intelligent-soft-robots/ball_launcher_hardware/README.md

# Ball Launcher Hardware

This repo provides materials for duplication and distribution of our open-source table tennis ball launcher AIMY.

Given are:
- Datasheets
- Technical sketches of all assemblies
- CAD models given as SolidWorks-files and STEP-files
