intelligent-soft-robots/ball_launcher_hardware/(list of files, cad)

Other CAD files:
3d_models/ball_feeding_unit.STEP
3d_models/control_unit_with_housing.STEP
3d_models/ball_feeding_unit_intake.STEP
3d_models/launch_unit.STEP
3d_models/base_frame_with_supply_channel.STEP
3d_models/reservoir_stirrer.STEP
3d_models/launch_unit_shooting_wheel.STEP
3d_models/electronics_box.STEP
3d_models/launch_unit_steering_tube.STEP
3d_models/cable_duct.STEP
3d_models/launch_unit_bearing.STEP
3d_models/aimy.STEP
3d_models/aimy_without_screws.STEP
