intelligent-soft-robots/ball_launcher_hardware/technical_drawings/assembly_ball_feeding_unit_3D.PDF

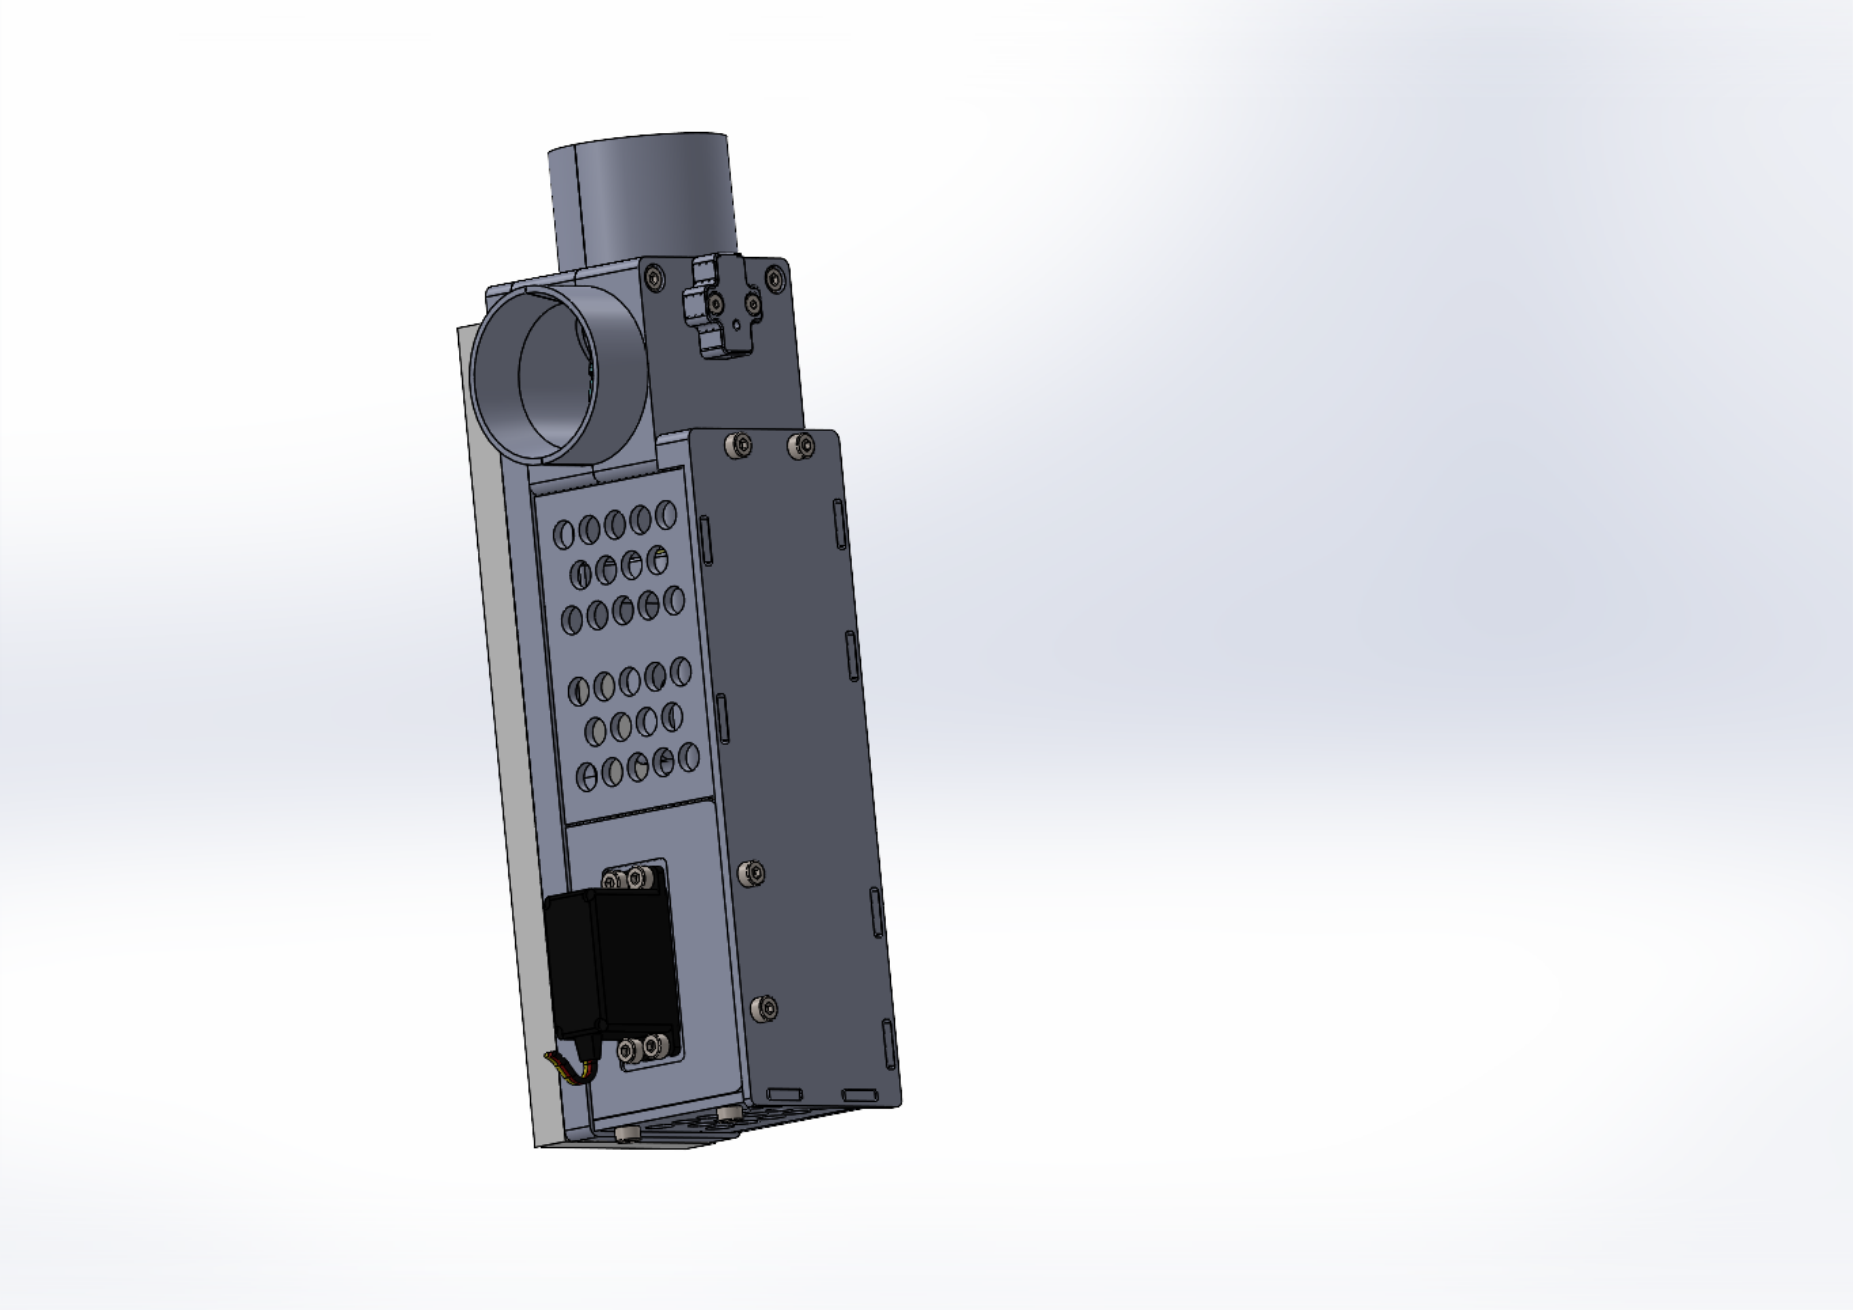
[picture p13: page 1]
