intelligent-soft-robots/ball_launcher_hardware/technical_drawings/assembly_cable_duct_3D.PDF

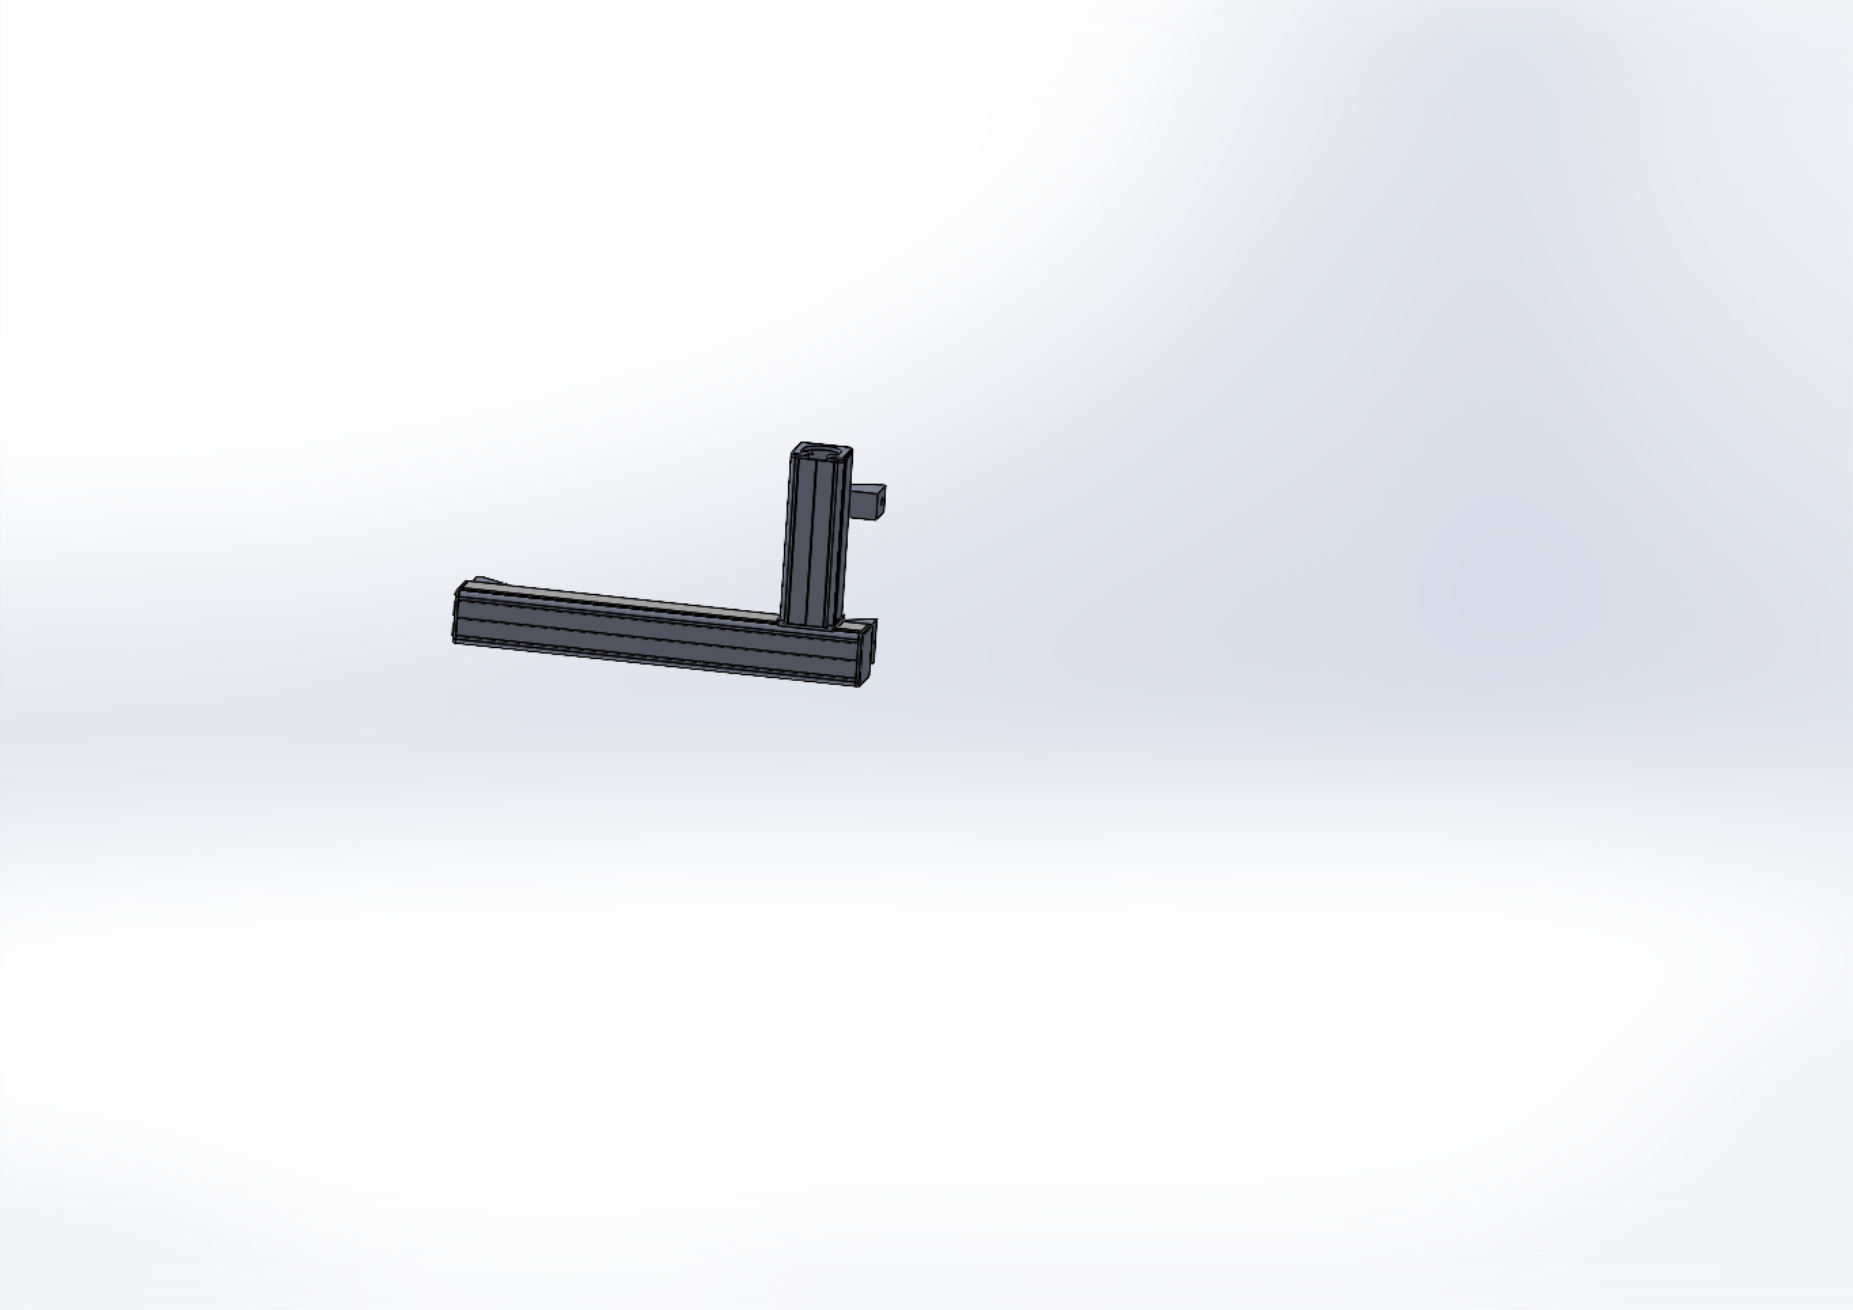
[picture p14: page 1]
