intelligent-soft-robots/ball_launcher_hardware/technical_drawings/assembly_aimy.pdf

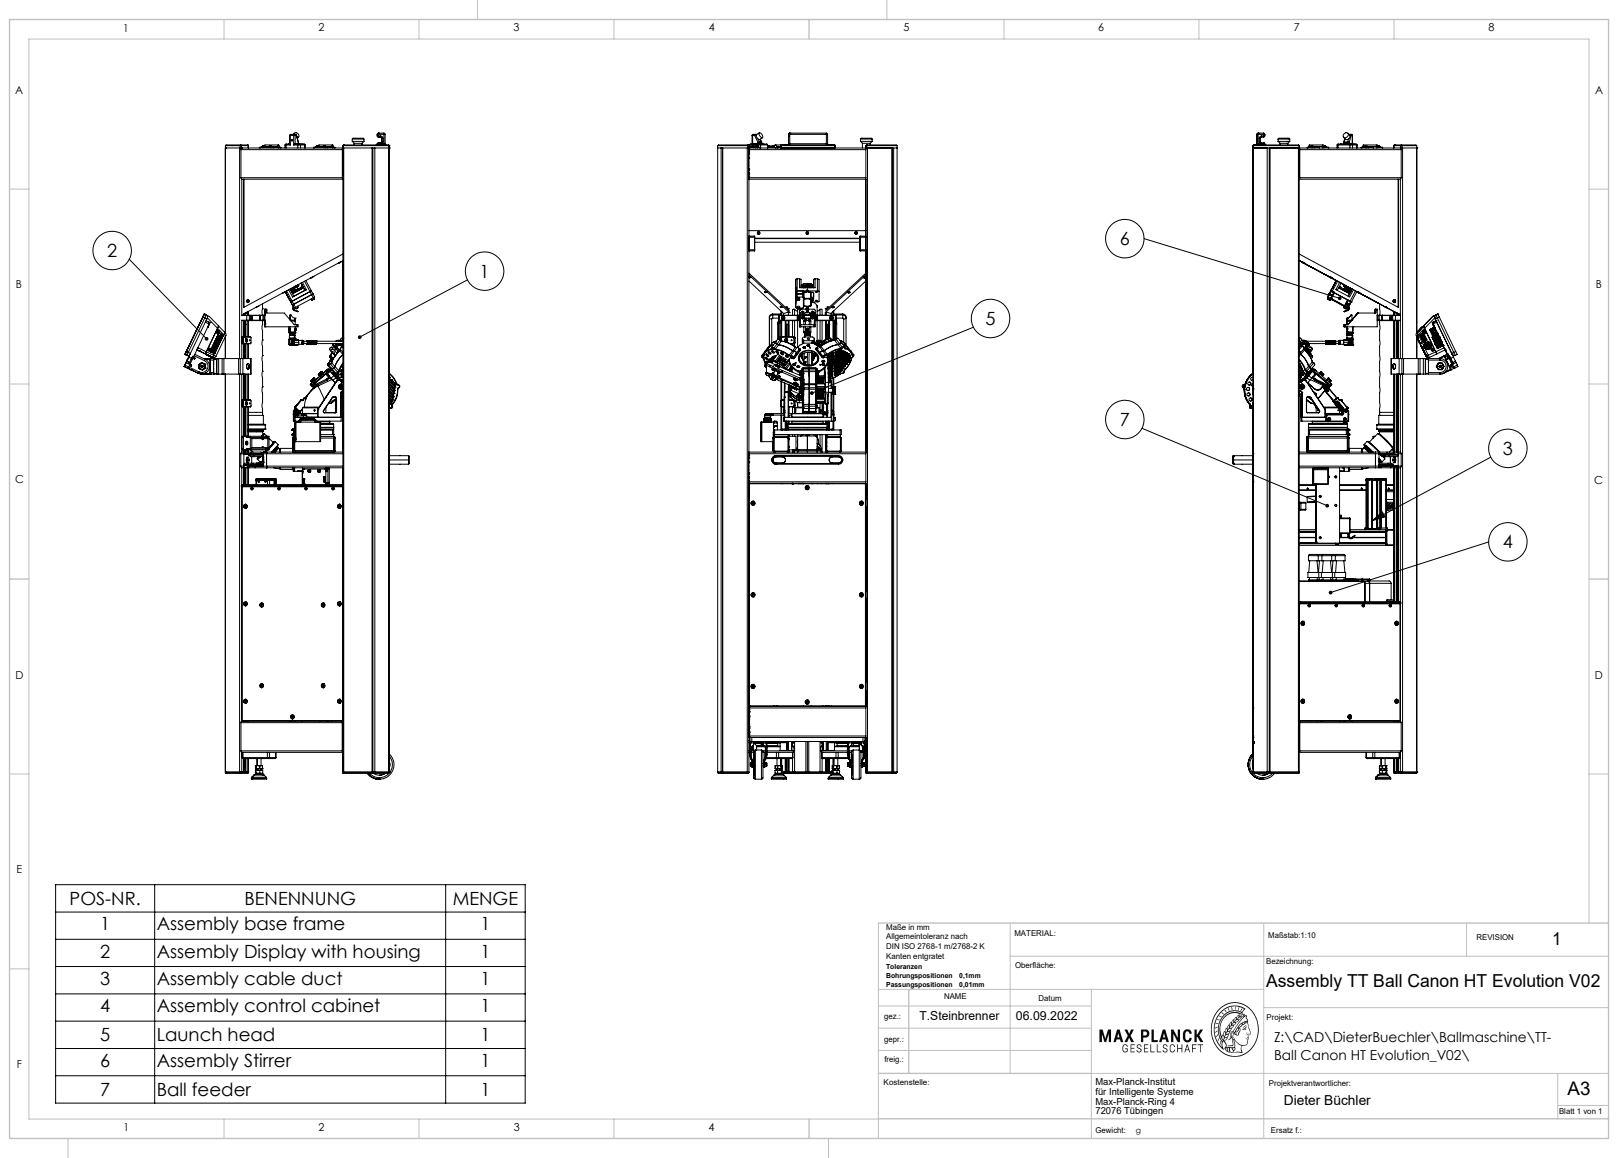
[picture p1: page 1]
Assembly Stirrer; Ball feeder; Ersatz f.:; Blatt 1 von 1; Dieter Büchler

POS-NR. | BENENNUNG | MENGE
1 | Assembly base frame | 1
2 | Assembly Display with housing | 1
3 | Assembly cable duct | 1
4 | Assembly control cabinet | 1
5 | Launch head | 1

Maße in mm Allgemeintoleranz nach DIN ISO 2768-1 m/2768-2 K Kanten entgratet Toleranzen Bohrungspositionen 0,1mm Passungspositionen 0,01mm | | Maßstab:1:10 | 1 REVISION MATERIAL:

Oberfläche: | Bezeichnung: Assembly TT Ball Canon HT Evolution V02

NAME | Datum

gez.: | T.Steinbrenner | 06.09.2022 | | Projekt: Z:\CAD\DieterBuechler\Ballmaschine\TT-Ball Canon HT Evolution_V02\

gepr.:

Max-Planck-Institut
für Intelligente Systeme
Max-Planck-Ring 4
72076 Tübingen
Gewicht:
