intelligent-soft-robots/ball_launcher_hardware/technical_drawings/assembly_ball_feeding_unit_intake.pdf

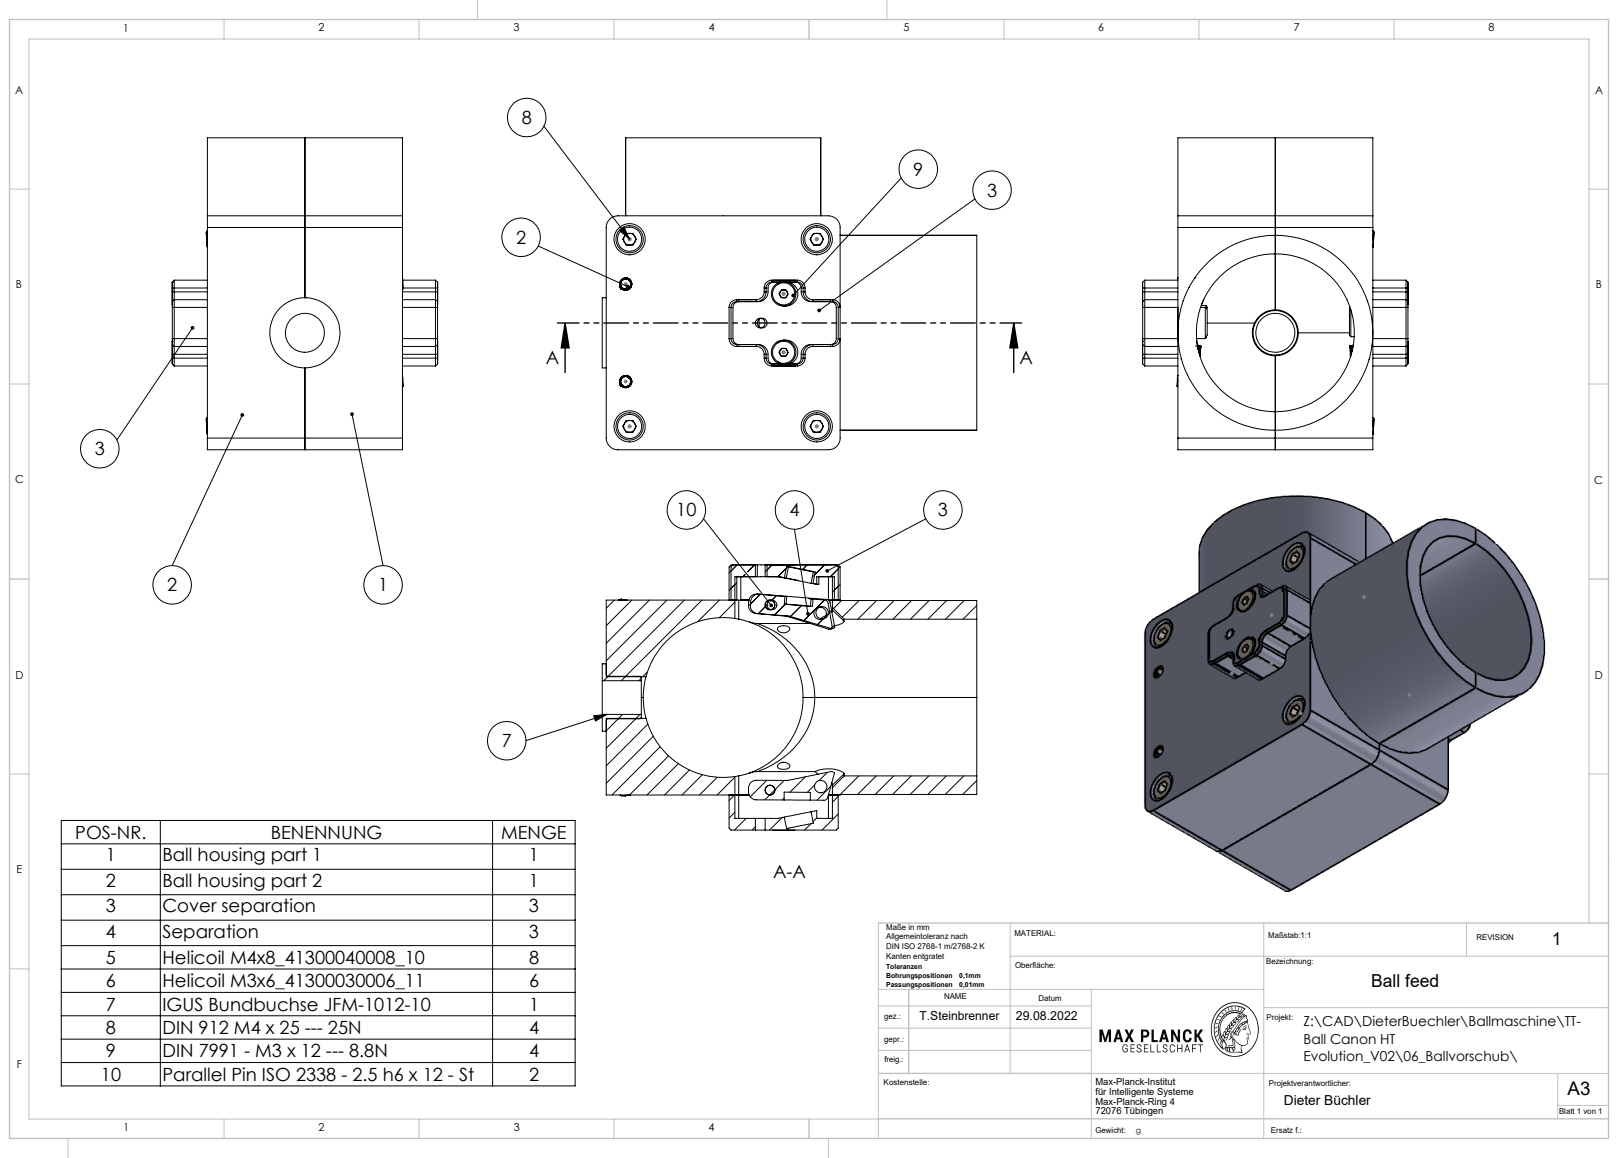
[picture p3: page 1]
IGUS Bundbuchse JFM-1012-10; Ersatz f.:; Blatt 1 von 1; REVISION MATERIAL:

POS-NR. | BENENNUNG | MENGE
1 | Ball housing part 1 | 1
2 | Ball housing part 2 | 1
3 | Cover separation | 3

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

5 | Helicoil M4x8_41300040008_10 | 8
6 | Helicoil M3x6_41300030006_11 | 6
8 | DIN 912 M4 x 25 --- 25N | 4
9 | DIN 7991 - M3 x 12 --- 8.8N | 4
10 | Parallel Pin ISO 2338 - 2.5 h6 x 12 - St | 2

Oberfläche: | Bezeichnung: Ball feed

gez.: | T.Steinbrenner | 29.08.2022 | | Projekt: Z:\CAD\DieterBuechler\Ballmaschine\TT-Ball Canon HT Evolution_V02\06_Ballvorschub\

gepr.:
freig.:

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
