intelligent-soft-robots/ball_launcher_hardware/technical_drawings/assembly_base_frame_with_supply_channel.pdf

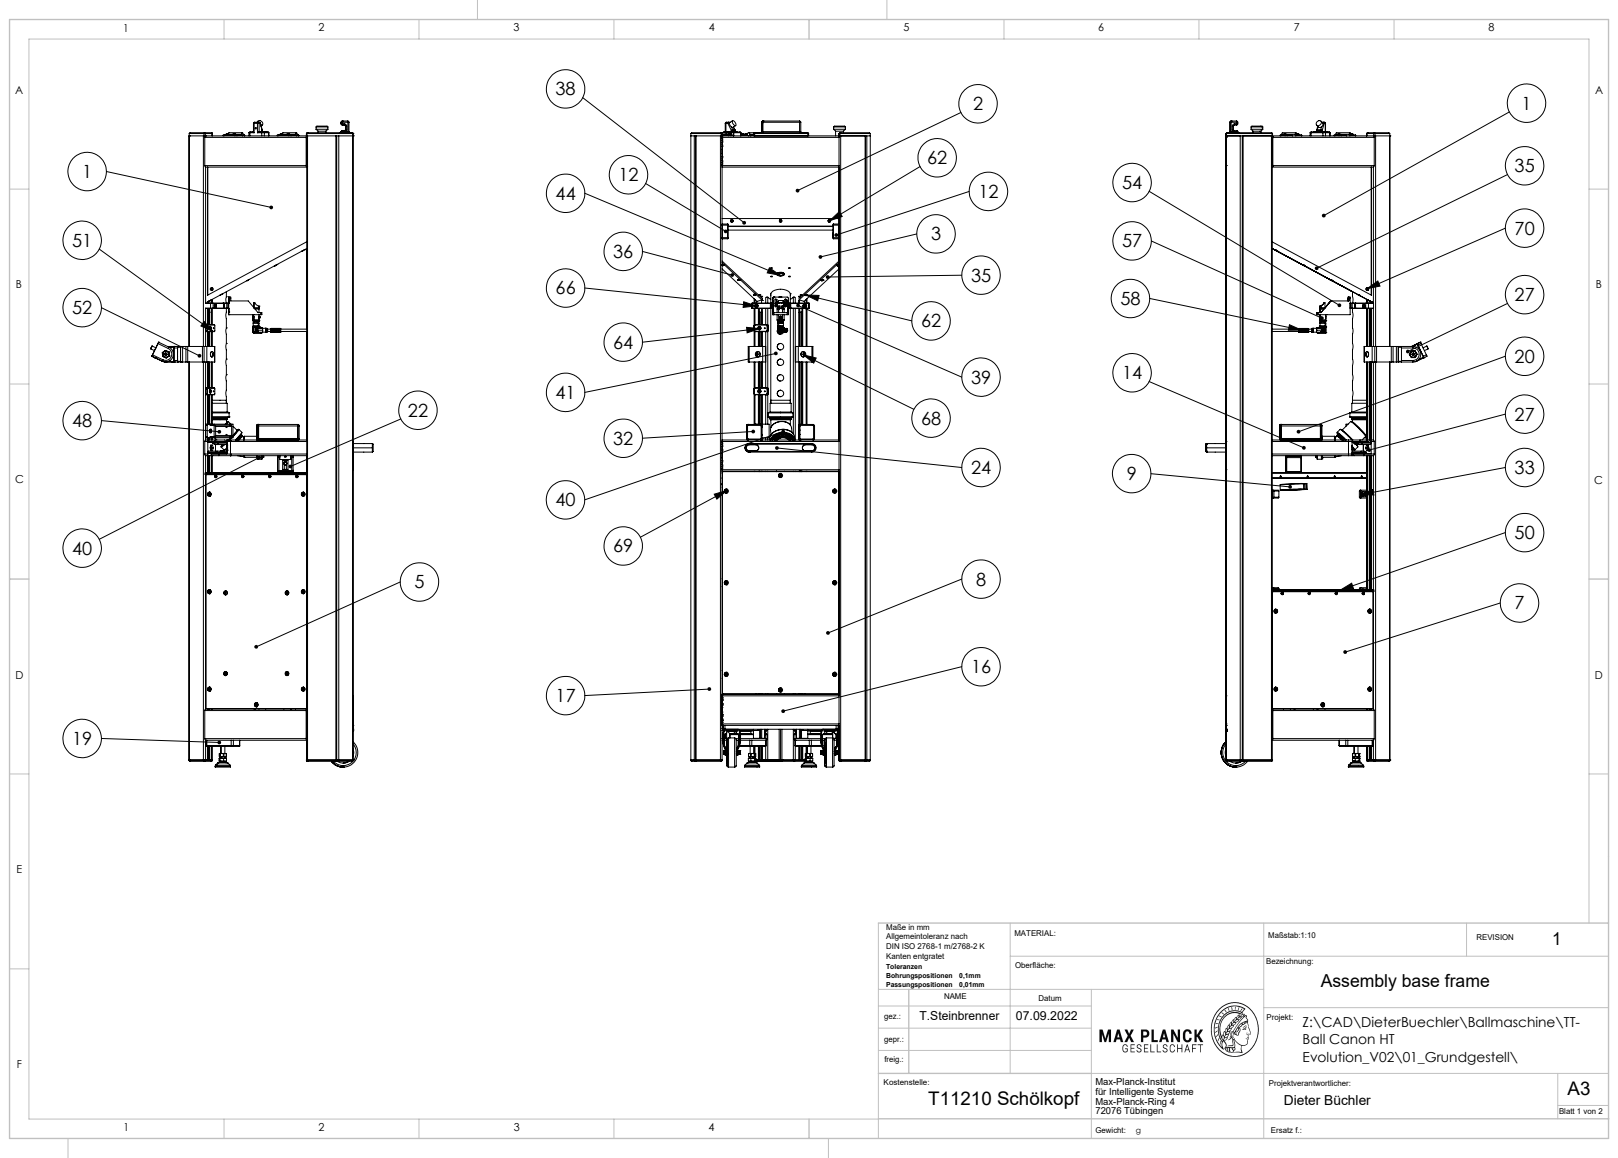
[picture p4: page 1]
Ersatz f.:; Blatt 1 von 2

Maße in mm Allgemeintoleranz nach DIN ISO 2768-1 m/2768-2 K Kanten entgratet Toleranzen Bohrungspositionen 0,1mm Passungspositionen 0,01mm | | Maßstab:1:10 | 1 REVISION MATERIAL:

Oberfläche: | Bezeichnung: Assembly base frame

NAME | Datum

gez.: | T.Steinbrenner | 07.09.2022 | | Projekt: Z:\CAD\DieterBuechler\Ballmaschine\TT-Ball Canon HT Evolution_V02\01_Grundgestell\

gepr.:
freig.:

Kostenstelle: T11210 Schölkopf | Max-Planck-Institut für Intelligente Systeme Max-Planck-Ring 4 72076 Tübingen | Projektverantwortlicher: Dieter Büchler | A3

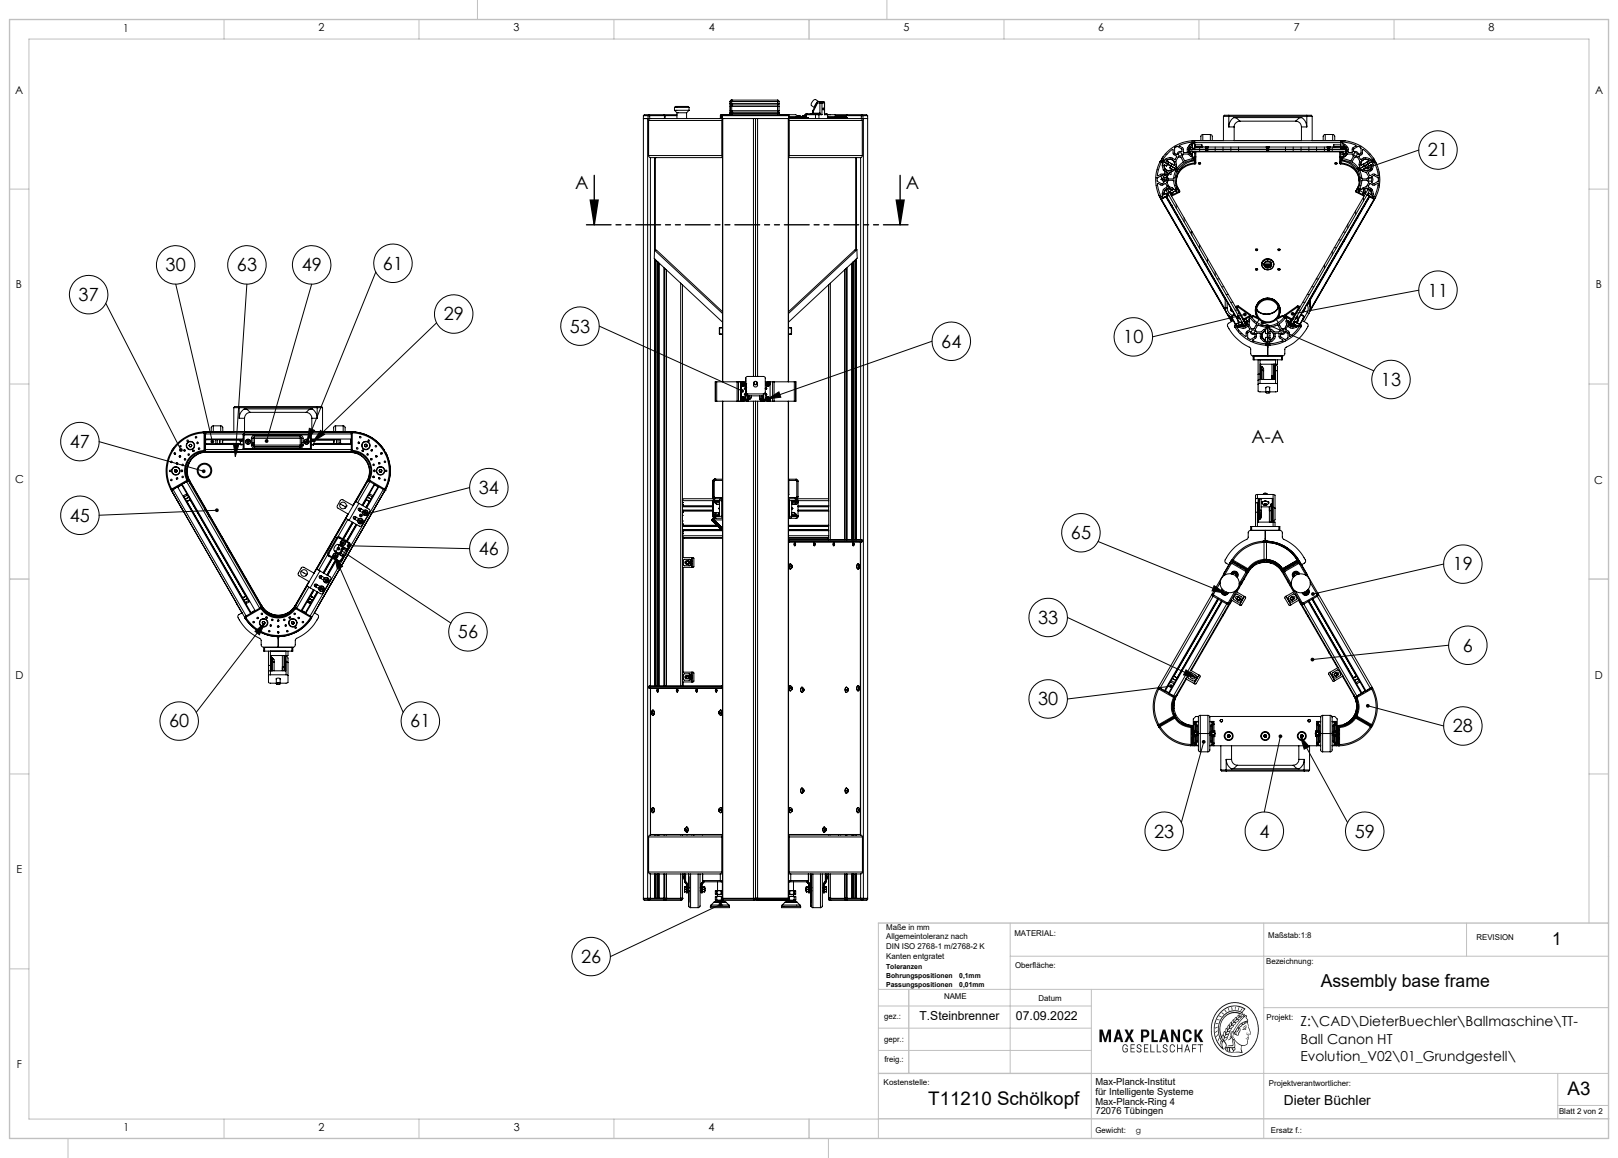
[picture p5: page 2]
Ersatz f.:; Blatt 2 von 2

Maße in mm Allgemeintoleranz nach DIN ISO 2768-1 m/2768-2 K Kanten entgratet Toleranzen Bohrungspositionen 0,1mm Passungspositionen 0,01mm | | Maßstab:1:8 | 1 REVISION MATERIAL:

Oberfläche: | Bezeichnung: Assembly base frame

NAME | Datum

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

gepr.:
freig.:

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
