intelligent-soft-robots/ball_launcher_hardware/technical_drawings/assembly_cable_duct.pdf

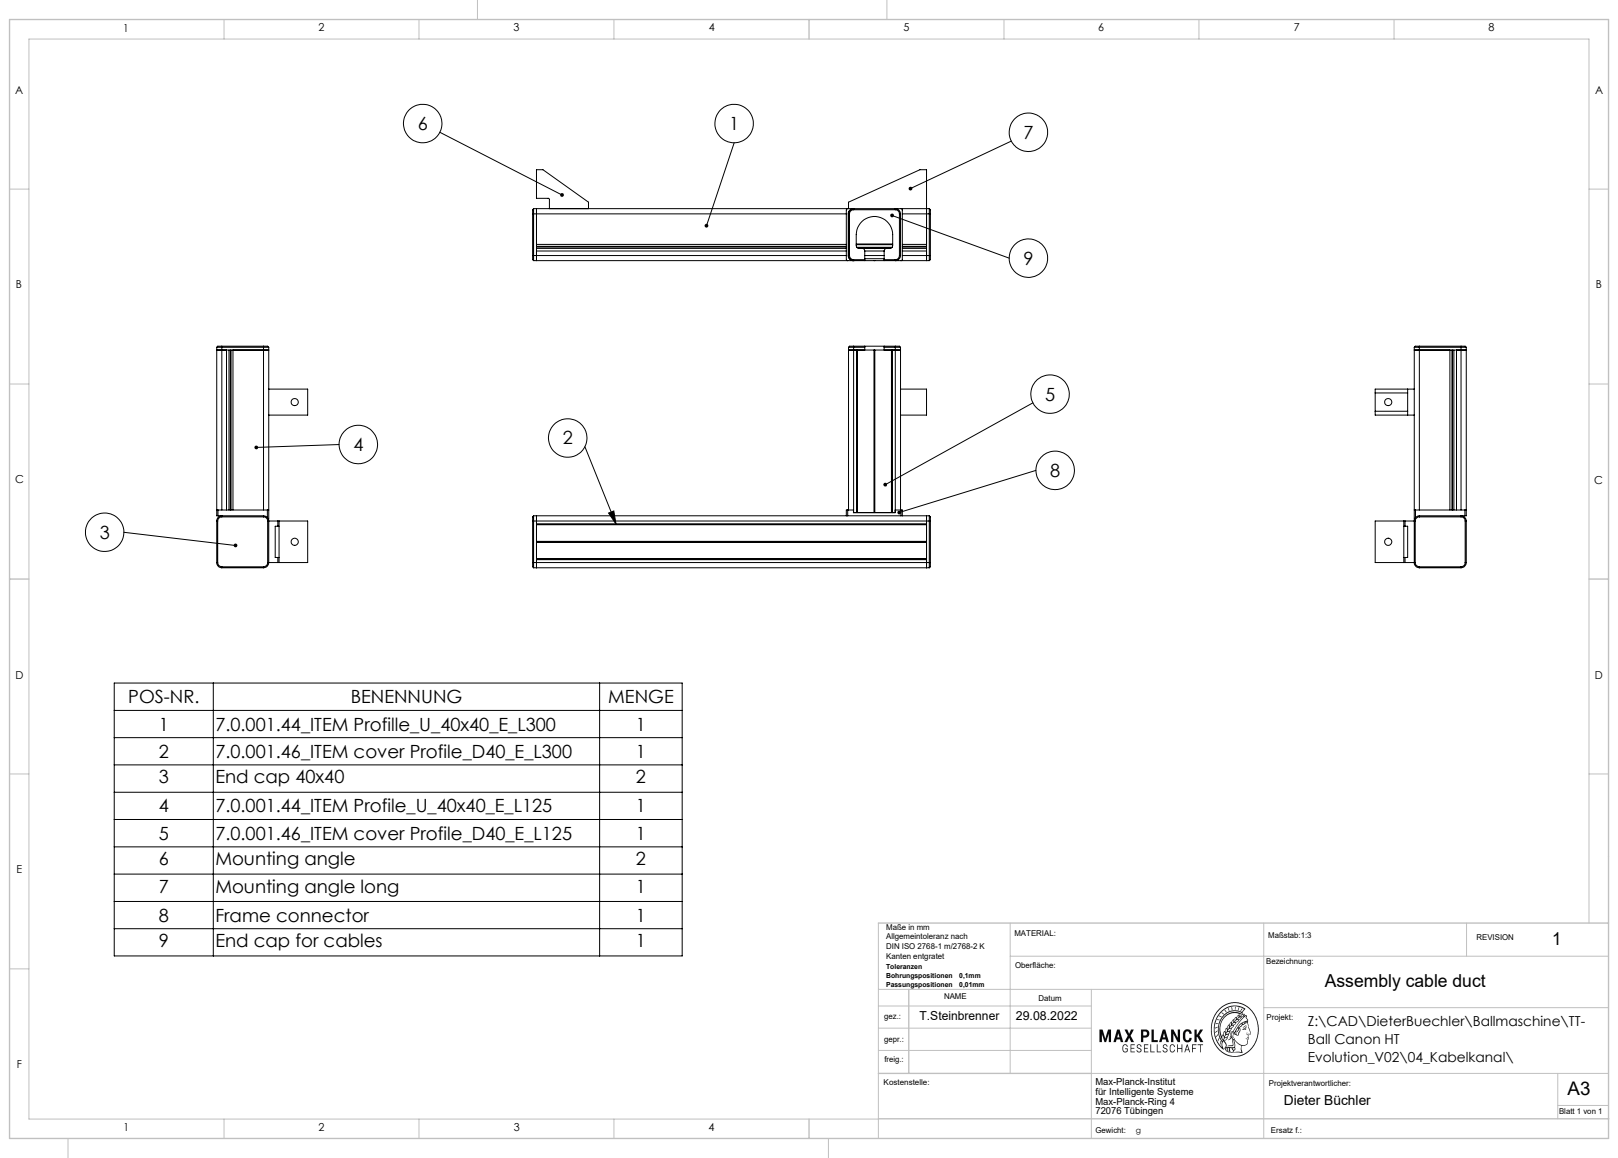
[picture p6: page 1]
Ersatz f.:; Blatt 1 von 1

POS-NR. | BENENNUNG | MENGE
1 | 7.0.001.44_ITEM Profille_U_40x40_E_L300 | 1
2 | 7.0.001.46_ITEM cover Profile_D40_E_L300 | 1
3 | End cap 40x40 | 2
4 | 7.0.001.44_ITEM Profile_U_40x40_E_L125 | 1
5 | 7.0.001.46_ITEM cover Profile_D40_E_L125 | 1
6 | Mounting angle | 2
7 | Mounting angle long | 1
8 | Frame connector | 1
9 | End cap for cables | 1

Maße in mm Allgemeintoleranz nach DIN ISO 2768-1 m/2768-2 K Kanten entgratet Toleranzen Bohrungspositionen 0,1mm Passungspositionen 0,01mm | | Maßstab:1:3 | 1 REVISION MATERIAL:

Oberfläche: | Bezeichnung: Assembly cable duct

NAME | Datum

gez.: | T.Steinbrenner | 29.08.2022 | | Projekt: Z:\CAD\DieterBuechler\Ballmaschine\TT-Ball Canon HT Evolution_V02\04_Kabelkanal\

gepr.:
freig.:

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
