intelligent-soft-robots/ball_launcher_hardware/technical_drawings/assembly_electronics_box.pdf

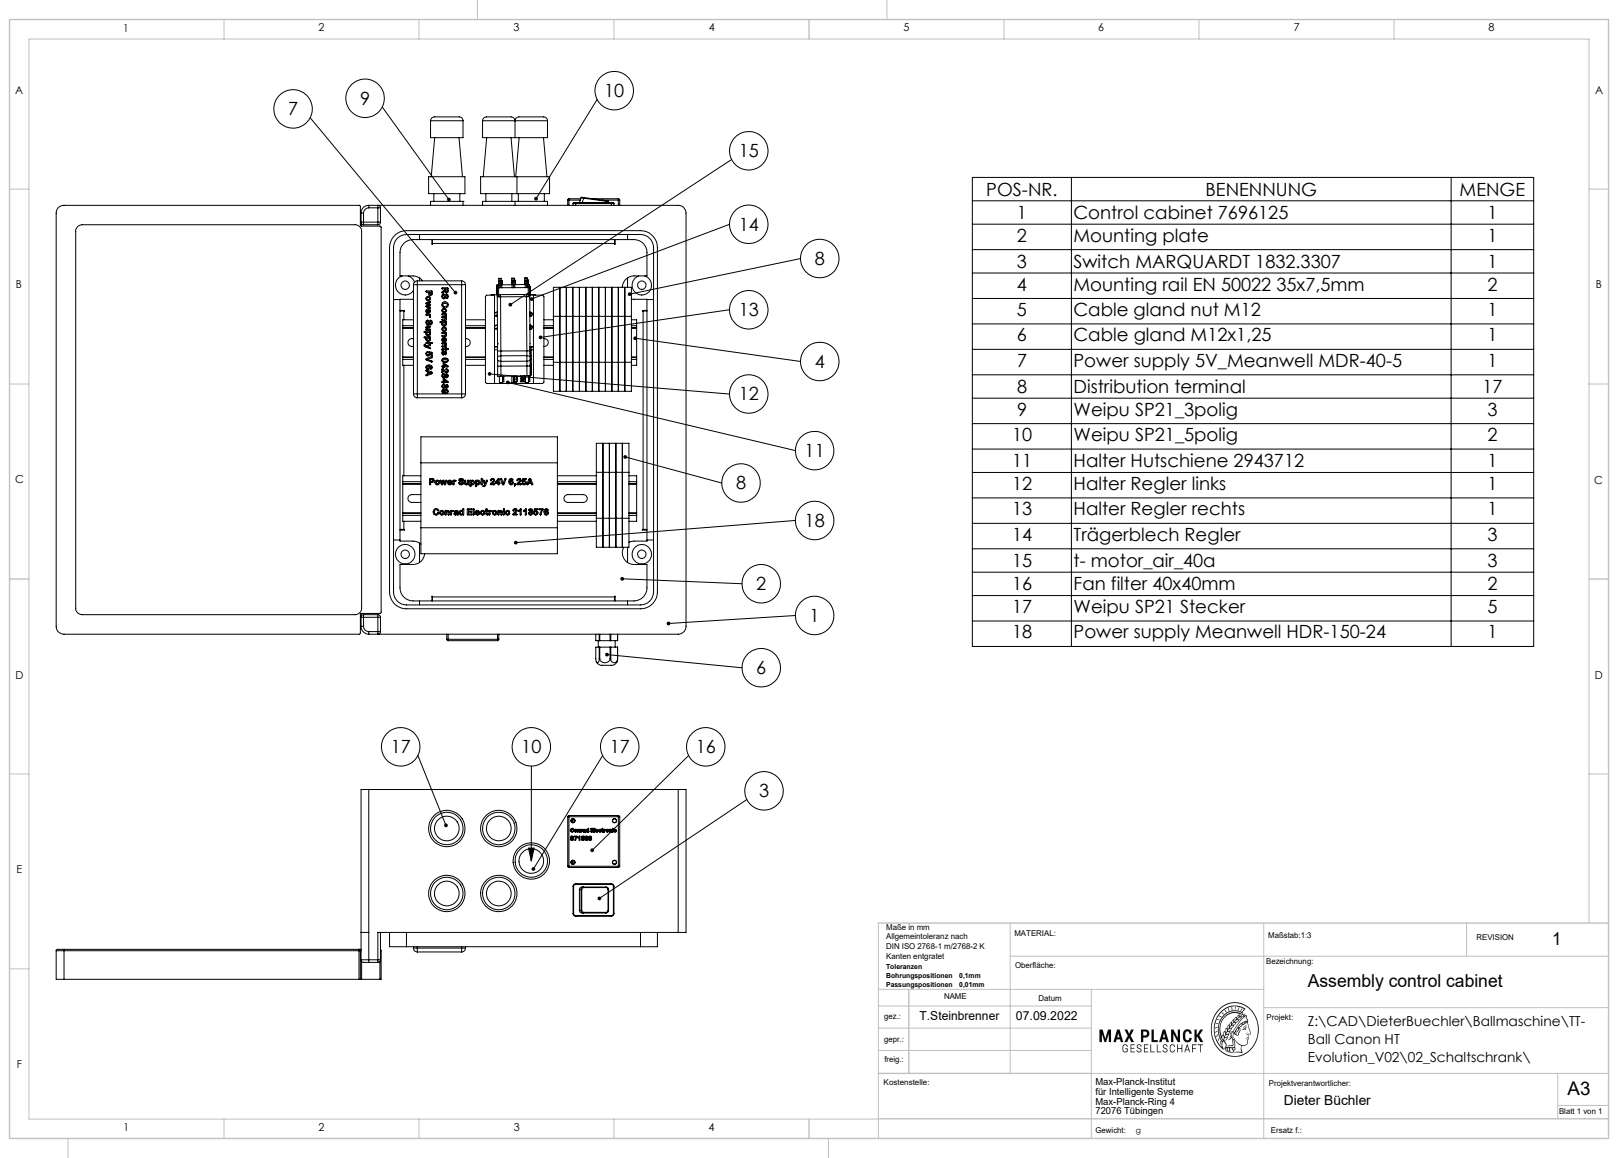
[picture p8: page 1]
POS-NR.; BENENNUNG; MENGE 1; Control cabinet 7696125; Mounting plate; Switch MARQUARDT 1832.3307; Mounting rail EN 50022 35x7,5mm; Cable gland nut M12; Cable gland M12x1,25; Power supply 5V_Meanwell MDR-40-5; Distribution terminal; Weipu SP21_3polig; Ersatz f.:; Blatt 1 von 1

10 | Weipu SP21_5polig | 2
11 | Halter Hutschiene 2943712 | 1
12 | Halter Regler links | 1
13 | Halter Regler rechts | 1
14 | Trägerblech Regler | 3
15 | t- motor_air_40a | 3
16 | Fan filter 40x40mm | 2
17 | Weipu SP21 Stecker | 5
18 | Power supply Meanwell HDR-150-24 | 1

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

Oberfläche: | Bezeichnung: Assembly control cabinet

NAME | Datum

gez.: | T.Steinbrenner | 07.09.2022 | | Projekt: Z:\CAD\DieterBuechler\Ballmaschine\TT-Ball Canon HT Evolution_V02\02_Schaltschrank\

gepr.:
freig.:

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
