intelligent-soft-robots/ball_launcher_hardware/technical_drawings/assembly_launch_unit_bearing.pdf

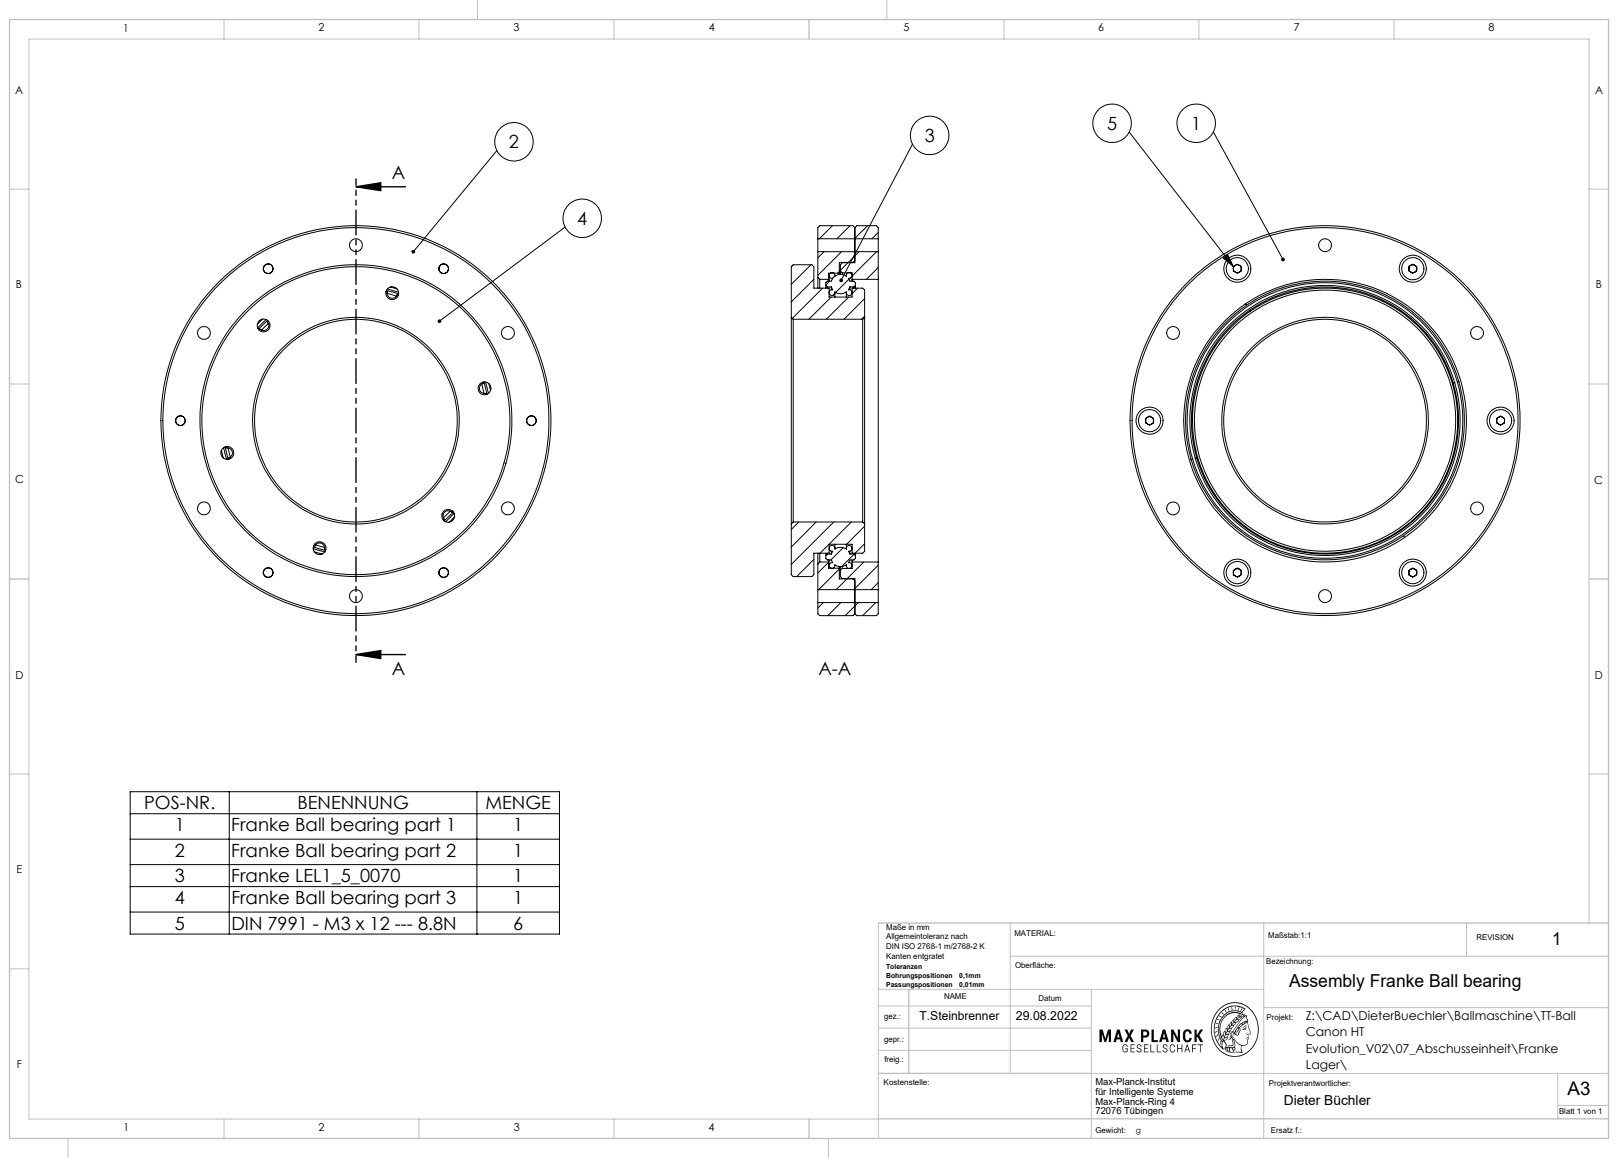
[picture p9: page 1]
Ersatz f.:; Blatt 1 von 1

POS-NR. | BENENNUNG | MENGE
1 | Franke Ball bearing part 1 | 1
2 | Franke Ball bearing part 2 | 1
3 | Franke LEL1_5_0070 | 1
4 | Franke Ball bearing part 3 | 1
5 | DIN 7991 - M3 x 12 --- 8.8N | 6

Maße in mm Allgemeintoleranz nach DIN ISO 2768-1 m/2768-2 K Kanten entgratet Toleranzen Bohrungspositionen 0,1mm Passungspositionen 0,01mm | | Maßstab:1:1 | 1 REVISION MATERIAL:

Oberfläche: | Bezeichnung: Assembly Franke Ball bearing

NAME | Datum

gez.: | T.Steinbrenner | 29.08.2022 | | Z:\CAD\DieterBuechler\Ballmaschine\TT-Ball Projekt: Canon HT Evolution_V02\07_Abschusseinheit\Franke Lager\

gepr.:
freig.:

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
