intelligent-soft-robots/ball_launcher_hardware/technical_drawings/assembly_launch_unit_steering_tube.pdf

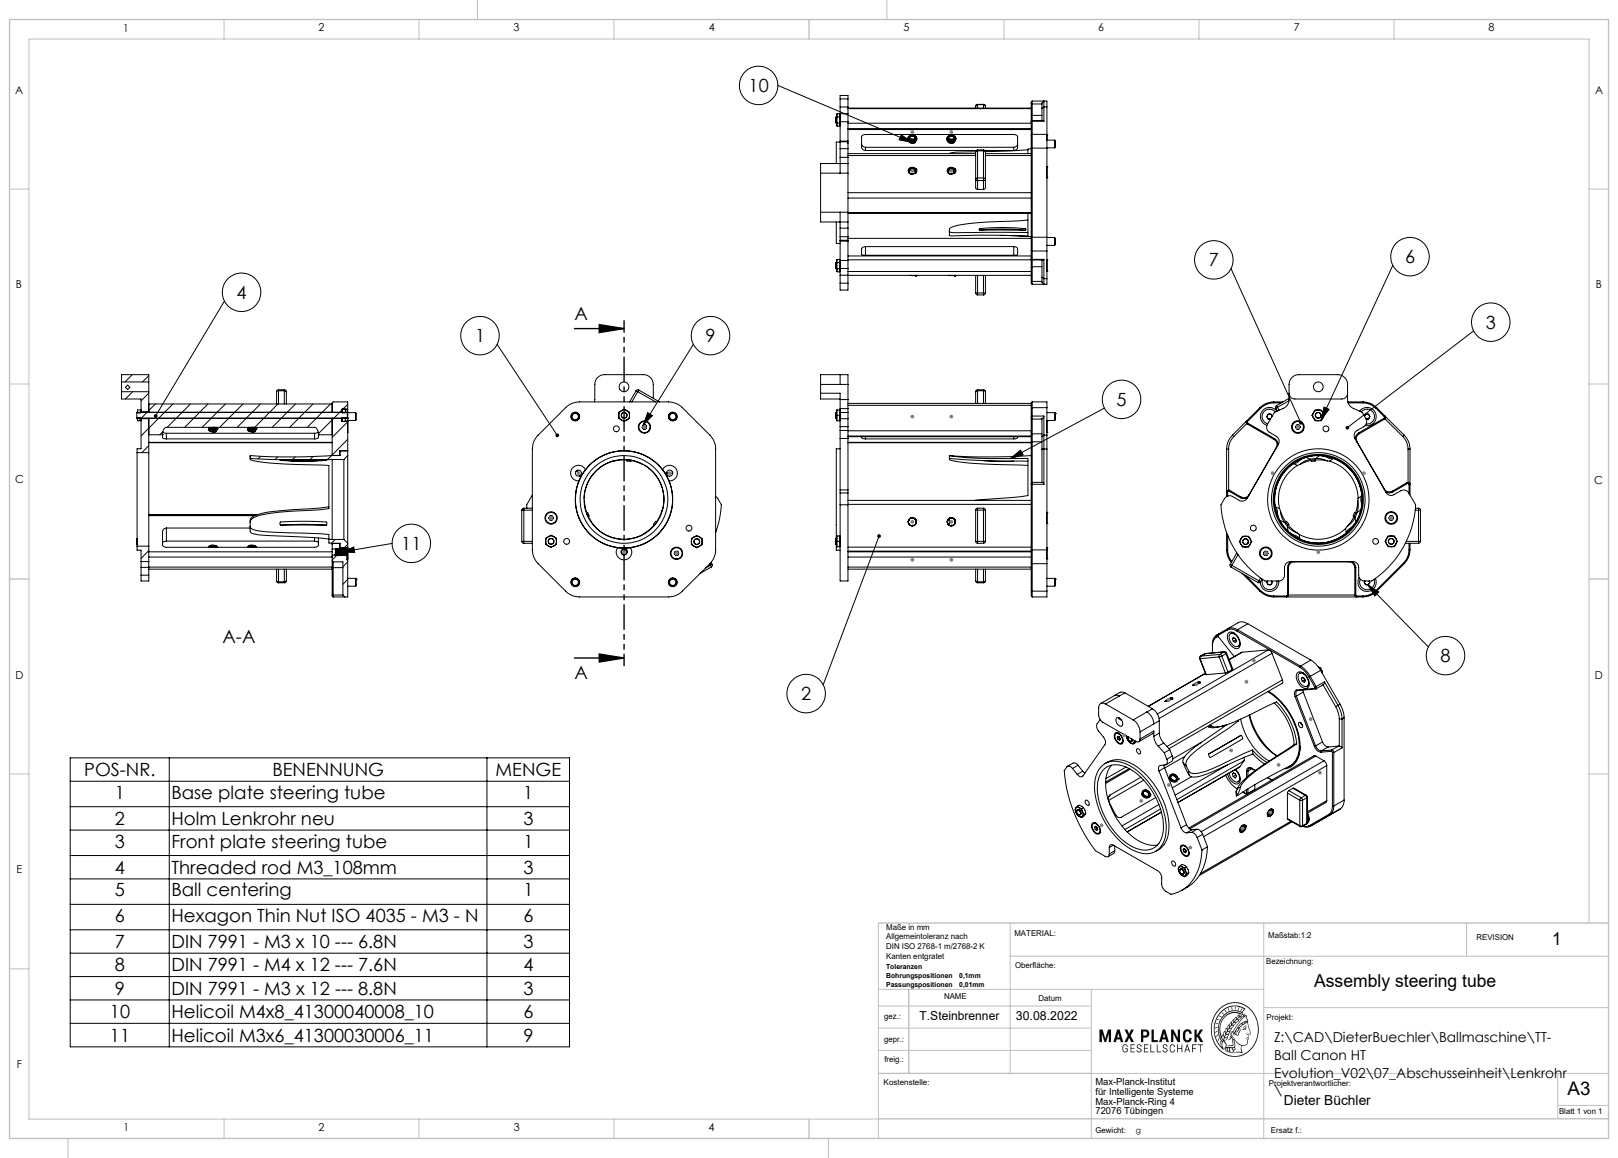
[picture p11: page 1]
DIN 7991 - M4 x 12 --- 7.6N; Ersatz f.:; Blatt 1 von 1

POS-NR. | BENENNUNG | MENGE
1 | Base plate steering tube | 1
2 | Holm Lenkrohr neu | 3
3 | Front plate steering tube | 1
4 | Threaded rod M3_108mm | 3
5 | Ball centering | 1
6 | Hexagon Thin Nut ISO 4035 - M3 - N | 6
7 | DIN 7991 - M3 x 10 --- 6.8N | 3
9 | DIN 7991 - M3 x 12 --- 8.8N | 3
10 | Helicoil M4x8_41300040008_10 | 6
11 | Helicoil M3x6_41300030006_11 | 9

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

Bezeichnung:
Assembly steering tube

NAME | Datum

gez.: | T.Steinbrenner | 30.08.2022 | | Projekt: Z:\CAD\DieterBuechler\Ballmaschine\TT-Ball Canon HT Evolution_V02\07_Abschusseinheit\Lenkrohr

gepr.:
freig.:

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
