intelligent-soft-robots/ball_launcher_hardware/technical_drawings/assembly_reservoir_stirrer.pdf

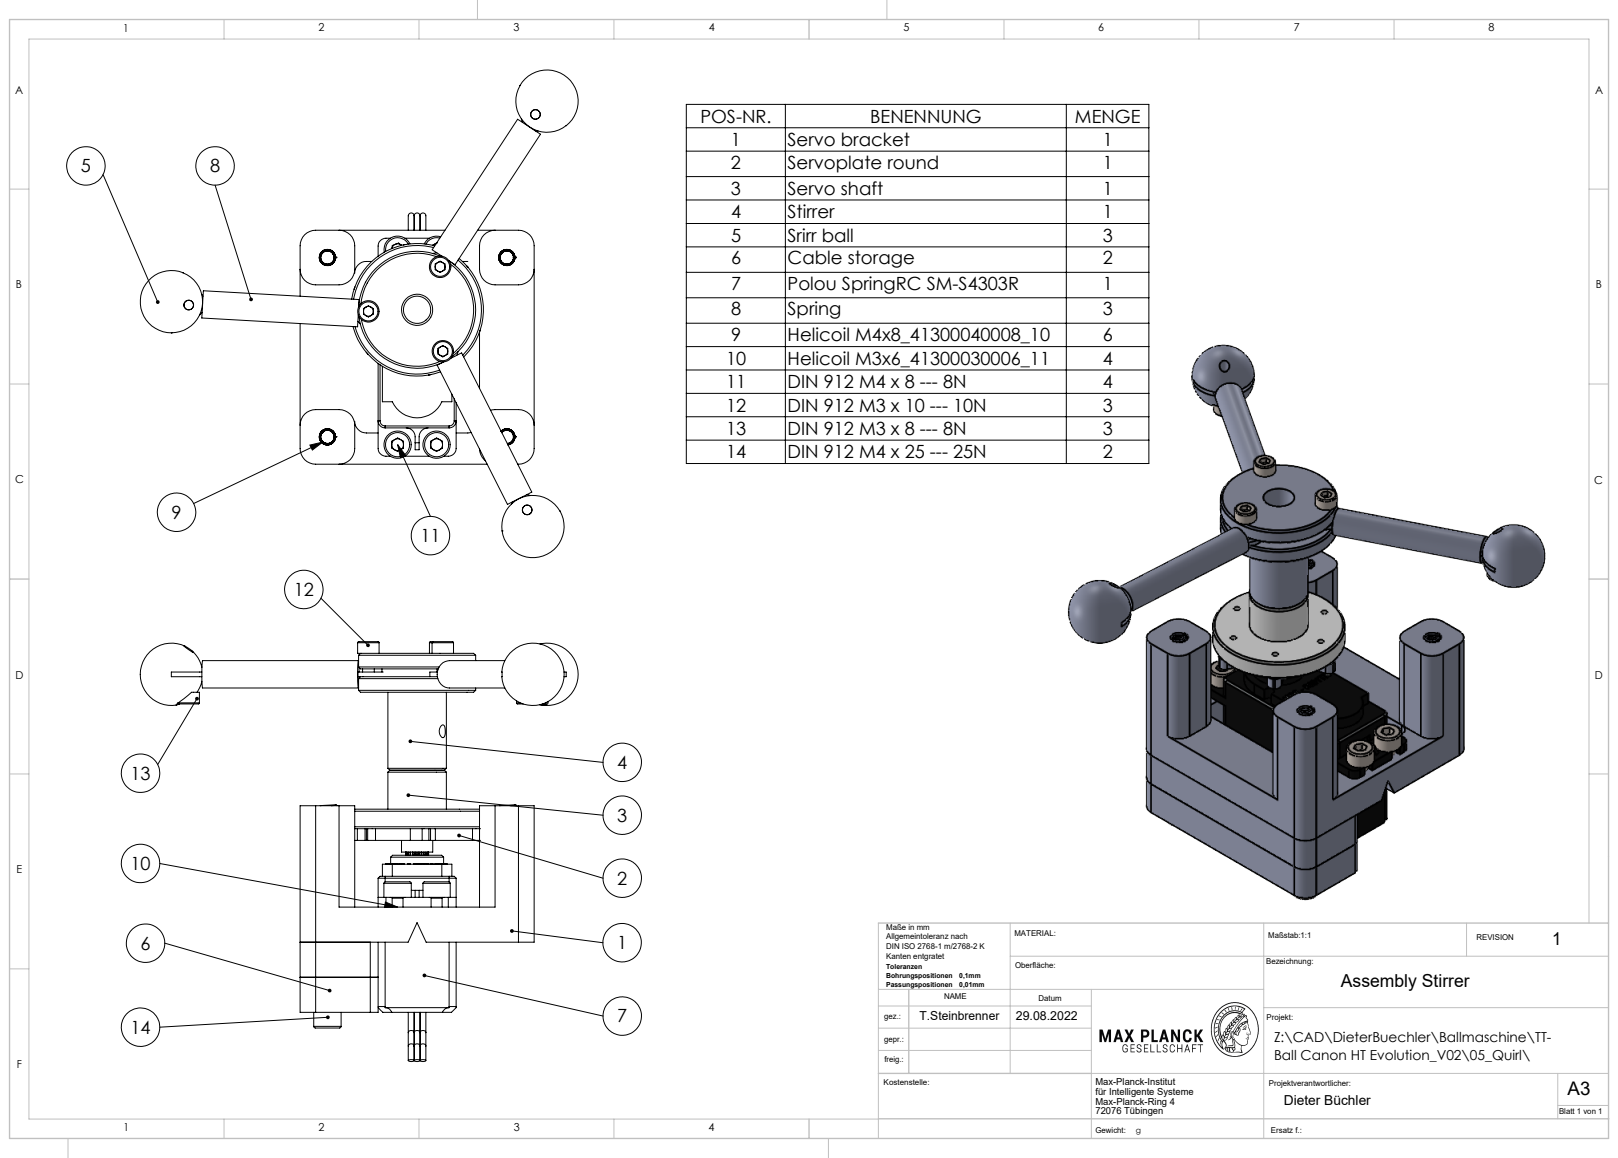
[picture p12: page 1]
Ersatz f.:; Blatt 1 von 1

POS-NR. | BENENNUNG | MENGE
1 | Servo bracket | 1
2 | Servoplate round | 1
3 | Servo shaft | 1
4 | Stirrer | 1
5 | Srirr ball | 3
6 | Cable storage | 2
7 | Polou SpringRC SM-S4303R | 1
8 | Spring | 3
9 | Helicoil M4x8_41300040008_10 | 6
10 | Helicoil M3x6_41300030006_11 | 4
11 | DIN 912 M4 x 8 --- 8N | 4
12 | DIN 912 M3 x 10 --- 10N | 3
13 | DIN 912 M3 x 8 --- 8N | 3
14 | DIN 912 M4 x 25 --- 25N | 2

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

Oberfläche: | Bezeichnung: Assembly Stirrer

NAME | Datum

gez.: | T.Steinbrenner | 29.08.2022 | | Projekt: Z:\CAD\DieterBuechler\Ballmaschine\TT-Ball Canon HT Evolution_V02\05_Quirl\

gepr.:
freig.:

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
